ewecan/CheezUNO/image/3D_PCB_CheeseUNO_B v2.png

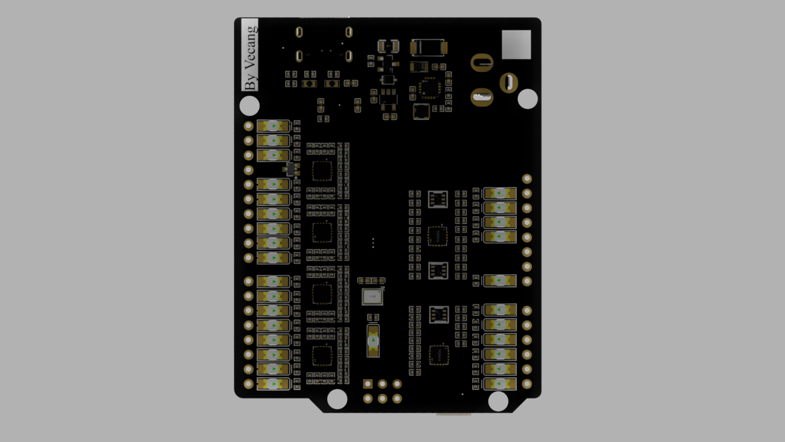
image/3D_PCB_CheeseUNO_B v2.png
