ewecan/CheezUNO/image/3D_PCB_CheeseUNO_T v2.png

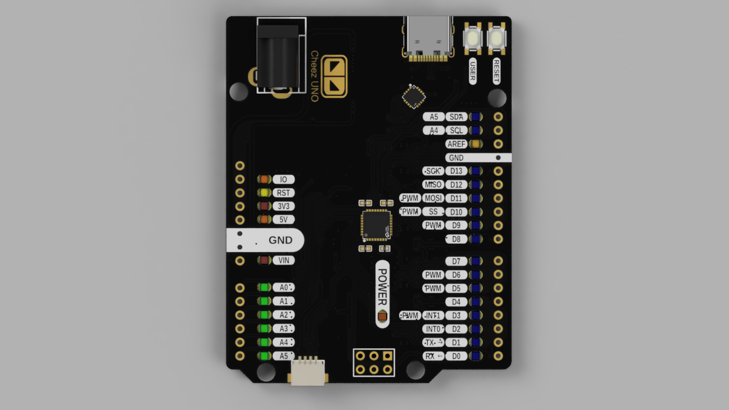
image/3D_PCB_CheeseUNO_T v2.png
