ewecan/CheezUNO/SCH_CheezUNO.pdf

A

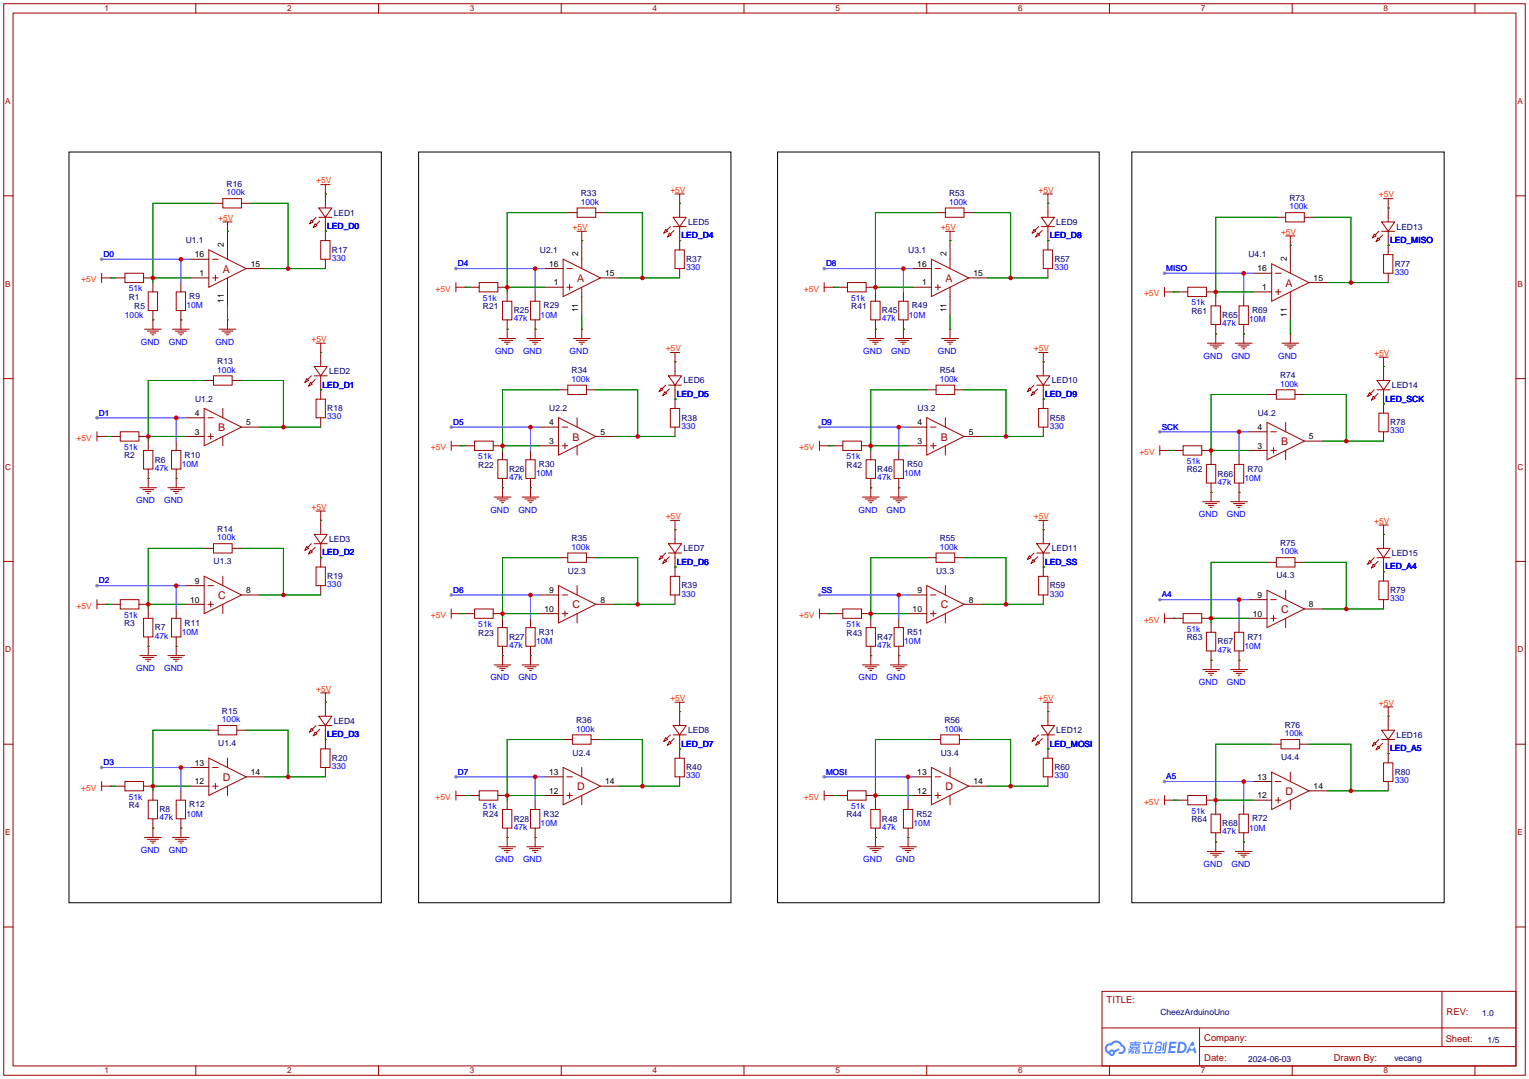
[picture p4: page 1]

A

A

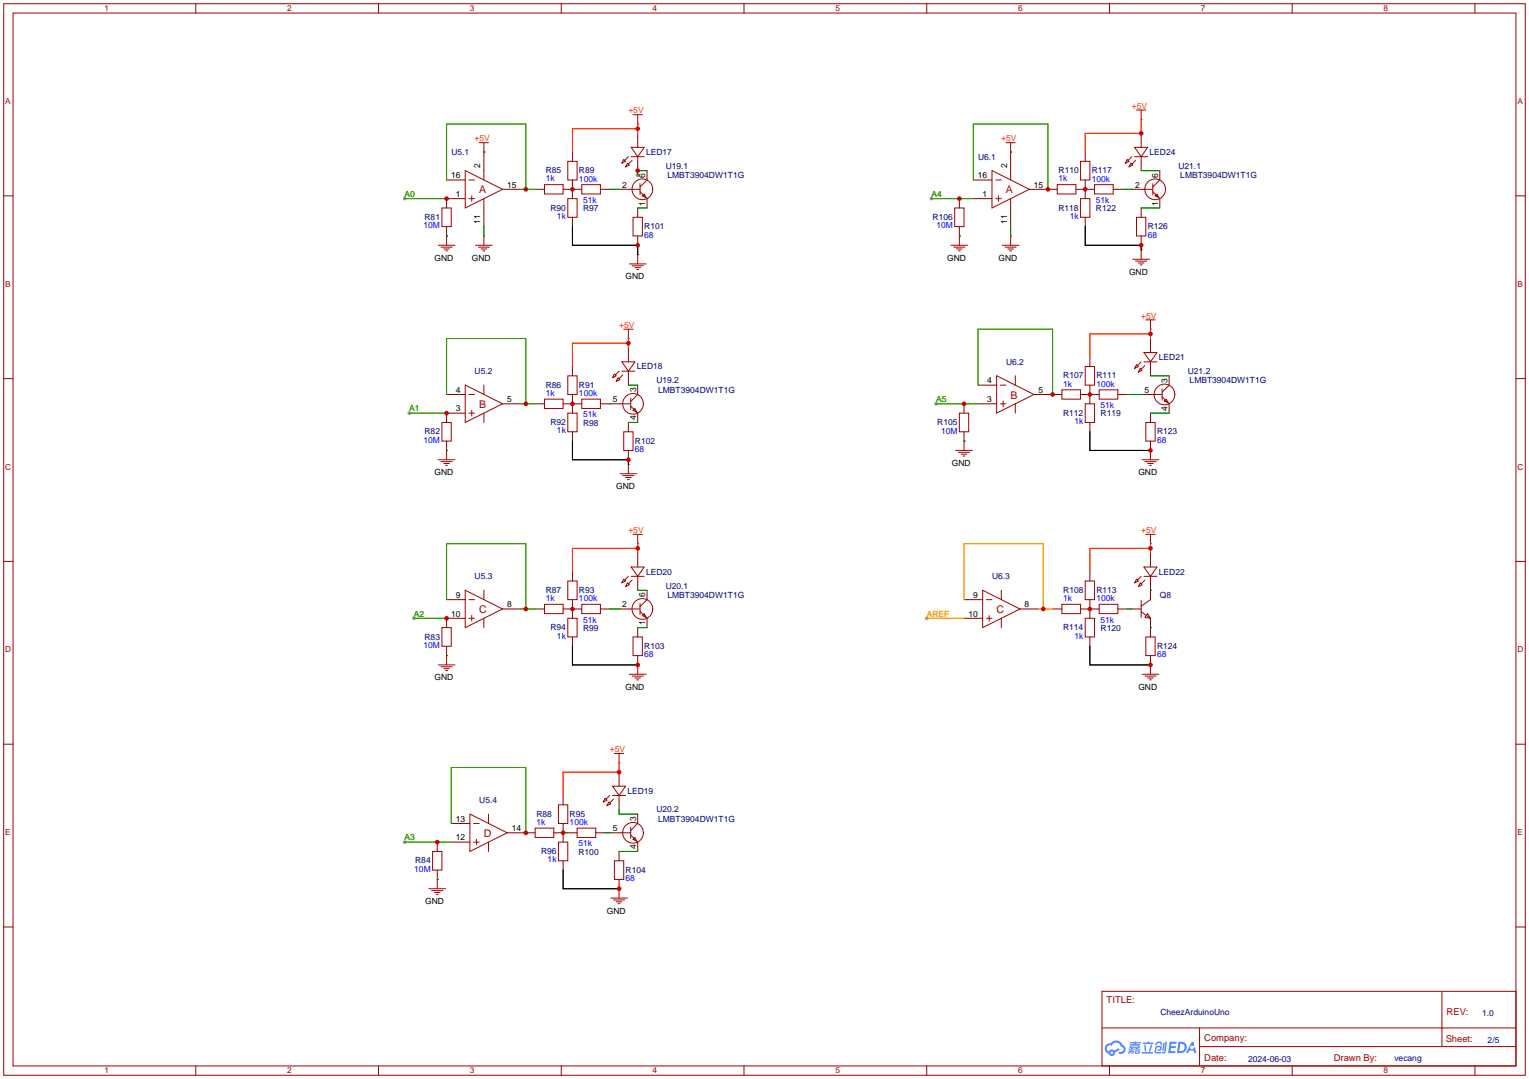
[picture p5: page 2]

# 电源切换电路

# DC-DC

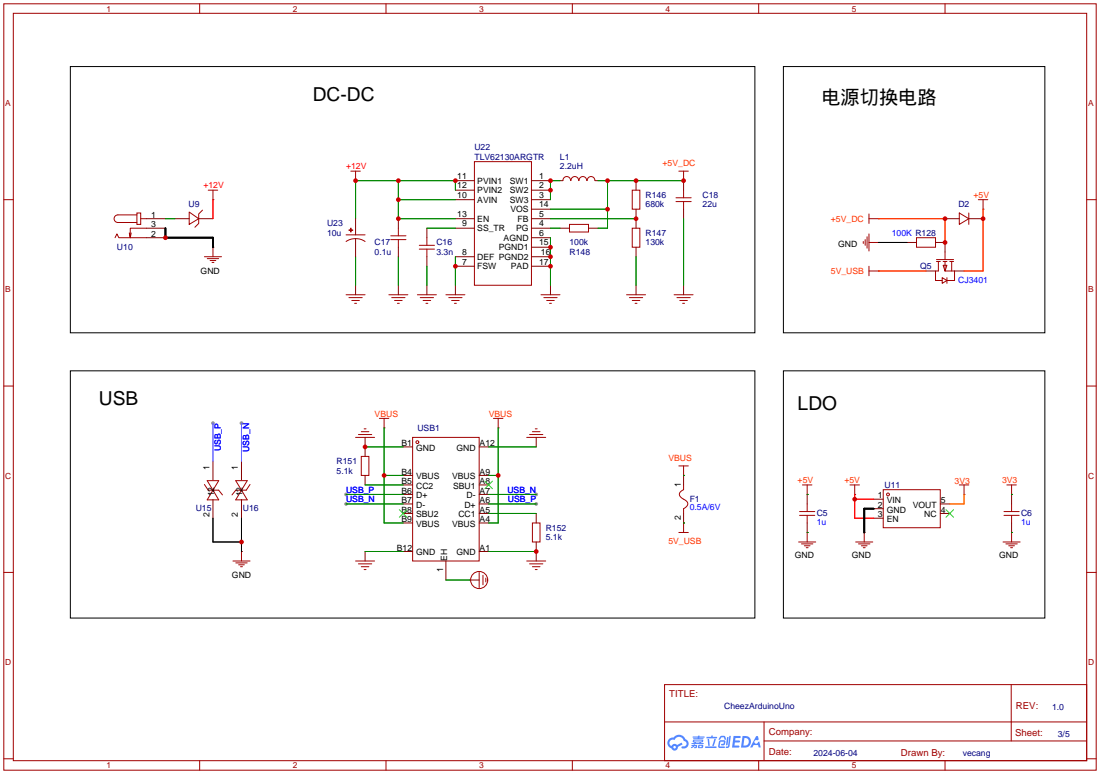
[picture p6: page 3]

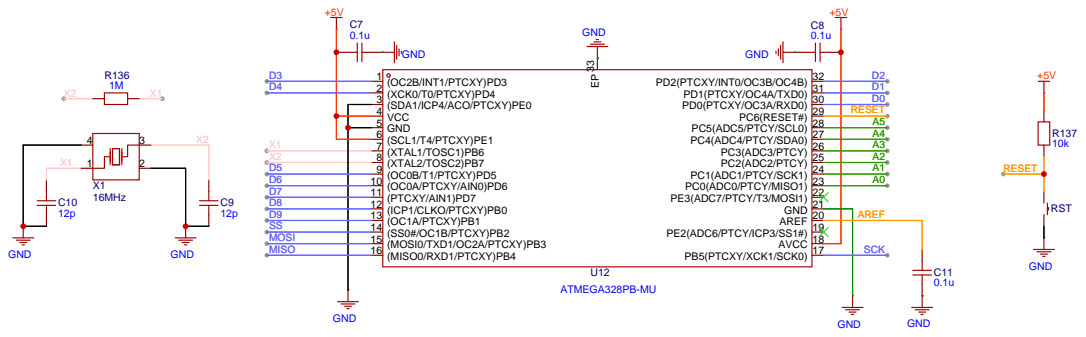
[picture p7: page 4]

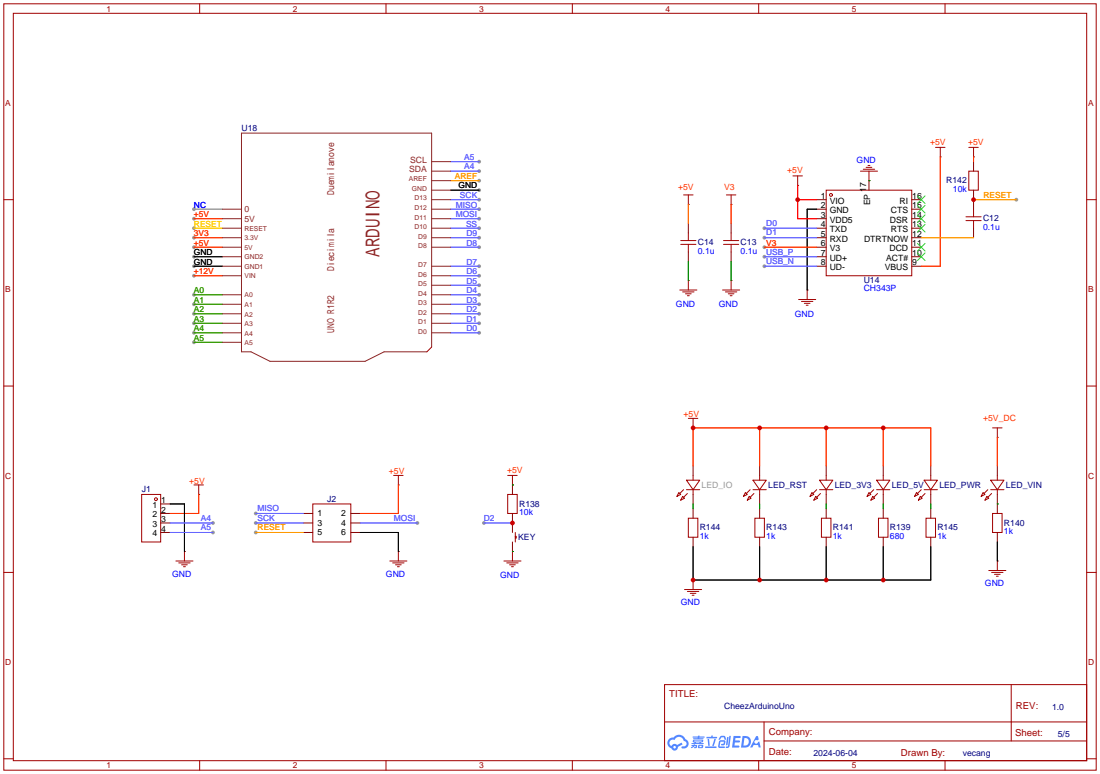
[picture p8: page 5]

ACT# 10 DCD 11 DTRTNOW 12 RTS 13 DSR 14 CTS 15 RI 16 EP ¹⁷
